Ryandev/n64-classic-mini-cad/(commit log)

2026-11-11 feat(cad): 50% N64-style case for the Radxa X4
    A parametric CadQuery enclosure with a geometry gate (135 rows) and a
    mutation self-test. CI builds every printed part and the print plate from a
    fresh clone; the reference-model checks run locally (see CREDITS.md).
    Published as one commit: earlier history held third-party marks.
2026-11-11 docs(cad): front, rear and print-plate pictures with the CLASSIC plaque
    Rendered in FreeCAD from the current export (the public CLASSIC lettering).
2026-11-11 chore(cad): ignore local even as a symlink
    The private workspace links cad/local in from outside the repo; a trailing
    slash only matches real folders.
2026-11-11 fix(cad): environment.yml builds from scratch
    ocp_vscode and ruff are PyPI packages, not conda ones, so micromamba could not
    solve the file and every CI run failed at environment setup. The local
    environment had them from pip, so nobody had built the file fresh. Both move to
    the pip section at the versions in use. Verified by creating a new environment
    from the file and running the CI steps against a clean clone.
2026-11-11 feat(cad): active cooling with a measured thermal budget (REQ-04)
    The case was effectively sealed (top louvers a 0.28 mm cosmetic cut) and
    the design milled a heat sink nobody can mill. Replaced with bought parts
    that fit as supplied:
    - Same Sky HSB26-343408 pin-fin heat sink on the N100 with paste (the stock
    silicone pad is the X4 cooler's known bottleneck), clamped by the printed
    duct's cover, which the cartridge cradle presses through a 0.5 mm pad.
    - Sunon MF30060V2 30x30x6 fan (15.7 dB(A)) under the 25 louvers, now cut
    through, blowing room air down a sealed duct through the pins. A 10 mm
    fan can't fit: it must clear the USB retainer bridge and the roof.
    - Exhaust: 9 floor vents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
2026-11-12 fix(cad): close the fan's bypass past the cooling duct (COOL_FAN)
    The fan reached 4.6 mm in front of the duct's front wall, and between the USB retainer
    brackets that strip was open down to the tub floor: 13 % of the blade area (66 mm2) blew
    into the case instead of through the heat sink, and lowered the plenum pressure. The owner
    spotted it in FreeCAD. COOL_SEAL had missed it because it treats the fan as a solid wall,
    and the thermal model sends the whole flow through the pins.
    - The duct gains a pocket under that strip (floor above the LED, side walls 0.2 mm inside
    the brackets, front wall under the fan frame), and its old front wall opens into it, so the
    strip blows into the plenum i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
2026-11-12 fix(cad): grade the case against Radxa's own board (C10); doors open to 90 deg (C1)
    C10: the Radxa X4 reference had been assembled by hand (connectors picked
    by index, an invented HDMI shield, a USB-C socket cut "to clear the
    standoff"), so every clearance row graded the case against a board edited
    to pass. `./run radxa-ref` (lib/step/build_radxa_x4.py) now builds it from
    Radxa's download: SHA-256 pinned, all 363 solids, moved only so its four
    mounting holes sit on the datum. New row RADXA_REF; CI builds it too.
    On the real board the duct, the upper shell and a standoff touched parts
    the edited model lacked: duct and shell reliefs, and the Radxa standoffs
    step to a 6.4 mm contact face for th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
2026-11-12 chore(cad): drop the hand-built Radxa STEP; notes on running heavy checks
    lib/component/radxa_x4_deported.step was the hand-built board input (C10),
    no longer read by anything; the assembly now labels Radxa's real model
    radxa_x4. Deleted with the owner's approval. AGENTS.md: N64_GATE_JOBS,
    selftest --only, one heavy job at a time.
2026-11-12 fix(cad): Omron switches screwed from behind the tower (C2)
    The hole-2 M2 screw entered from the switch's front, where its head and
    washer sat 25.5 mm3 inside the USB-A socket and no driver could reach it.
    Owner's design: a 3 x 10 thread-forming screw for plastics, driven from
    behind the tower (before the Radxa board) through a 3.4 mm clearance
    hole, rolls its own thread in the switch's 2.35 mm hole and clamps the
    switch to the tower: no play, nothing on the switch's front. The M2
    inserts, screws and washers go. Bench-test on a spare switch first.
    New row OMRON_SCREW (clear of tub/switch/USB/bracket, >= 4 mm engaged,
    tip >= 0.3 mm inside the switch front, 40 mm driver path); the screws
    are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
2026-11-12 fix(cad): every Omron switch clicks; buttons press the lever at their centre (C3)
    The buttons' flat underside met the switch lever's raised tip (1:1, 4 mm
    off-centre), and with 1.9 mm of travel a nominal SS-5GL (OP 8.8) never
    clicked; OMRON_ACT passed because it multiplied constants (a 0.72 ratio
    nothing produced). Owner chose a press point under the button centre:
    the underside is 0.33 mm lower with pockets either side of a 1.2 mm ridge
    72% along the lever, and travel is 2.10 mm (stops follow BUTTON_STOP_Z).
    OMRON_ACT now moves each real button down the real lever (Omron SS
    datasheet values): tip 10.66 mm at rest (releases every switch, margin
    0.26) and 7.82 at the stop (clicks every switc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
2026-11-12 fix(cad): REAR_IO measures the real RJ45 jack, not a relaxed width (C5)
    REAR_RJ45_BAY_W was a hand-set 24.0 relaxed to 20.5 so the row passed,
    its label still claiming 24. The row now requires the real jack assembly
    (17.0 mm) to sit >= 1.0 mm from the board and >= 0.5 mm from the wall
    (measured 1.0 / 3.0 in a 21.0 mm bay); the constant is gone. Red-
    confirmed: moving the jack onto the board fails REAR_IO.
2026-11-13 fix(cad): rows measure the solids; corner screws M3x14 (C8, C9)
    C8: SCALE, SCAN_50 and J01_SPLIT compare against the real N64 shell
    model at 50 % (was: datum constants vs hand-copied scan numbers);
    HANDED measures the built parts (POWER left, ports front, I/O rear,
    deck up; was the determinant of a constant matrix); RADXA_FIT and
    REAR_IO probe the tub's real walls (new lib/testing/probe.py); J01's
    lip gap and J07's light-pipe gap are measured (0.155 and 0.060 mm).
    Selftest mutations added for RADXA_FIT, M2_CLEAR, G13_FULL, G13_TOP,
    J04_RESET, J06_BEZEL, J07_PIPE, G13_FRONT and a mirrored-ports HANDED;
    all caught.
    C9: the M3x12 corner screws reached only 2.8 mm into their RX-M3x5.7
    inserts;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
2026-11-13 fix(cad): FEM with C3D10, converged meshes and real supports (C4)
    The FEM's peak stresses sat on point loads and clamps and didn't
    converge, its C3D4 tetrahedra were far too stiff, it clamped whole
    edges, it couldn't find its tools (gmsh/ccx missing from
    environment.yml, a lowercase glob for FreeCAD's AppImage), and LC2
    had silently lost its button-press load when the stop moved (C3).
    Now: straight-sided C3D10 (curved ones inverted on the tub); each case
    solved on two meshes (0.7x) that must agree within 15 %; stress judged
    at the 99th percentile clear of loads and supports; the tub rests on
    its floor, held sideways under the feet, the shell on the tub's rim,
    screwed at its corners; LC4's l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
2026-11-13 fix(cad): one XY datum per button; placed exports and the torus check tested (C9, D4)
    C9 (rule 3): each button was located in XY by both its shell chimney
    (0.22 mm a side) and the bracket's guide pole (0.20), on different
    parts whose placement stack (lip 0.15 + glued bracket 0.20) exceeds
    either clearance, so a button could bind. The chimney is the datum; the
    pole hole grows to Ø4.0 (0.57 mm a side, the whole stack) with a flat
    roof 0.3 mm above the pole tip at full stroke. New row BTN_DATUM
    measures both gaps on the solids; red-confirmed with the old Ø3.2.
    D4: export_validate compared placed component exports with get_shape();
    export_harness.export_shape() is now the one definition both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
2026-11-13 feat(cad): heat sink corner stops, V-bottom switch pin, print-test coupons
    The heat sink could slide 5.7 mm forward and more than 6 mm back on the die, held only by clamp
    friction and paste. Front posts hang from the duct cover and rear hooks from the skirts, 0.3 mm
    clear; row HS_STOP moves the sink 0.5 mm each way and needs it to meet the duct (red-confirmed:
    HS_STOP_GAP 0.3 -> 2.0 is caught). COOL_SEAL still seals.
    The Omron locator pin was a round 6.4 mm horizontal cantilever whose underside couldn't print;
    it now has a 45 deg V underside inscribed in the Ø2.2 circle. BTN_DATUM crops the poles once.
    ./run coupons cuts five print-test coupons from the real parts (button/chimney, switch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
2026-11-13 feat(cad): flat tub bottom, overhang row that fails, printing notes, hole gauge
    The tub's stepped underside (raised feet and label pad, floor 0.45-0.9 mm up) left ~9,500 mm^2
    of floor printing in mid-air. The underside is hidden under the Bumpon feet and the owner only
    replicates what is visible (C9, 2026-11-13), so the bottom is now flat at z 0 (bed contact
    2,176 -> 11,267 mm^2). The floor vents cut the thicker floor: declared 372.6 -> 518.4 mm^3.
    The overhang row was advisory and always passed, which is how the floating floor got through.
    It now fails any downward face wider than a 10 mm bridge (width = short side of the face's
    equivalent rectangle), unless the part declares SUPPORT_MM2 w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
2026-11-13 refactor(cad): delete five unused LED datums
    LED_SHAFT_D, LED_BORE_D and LED_BICOLOUR_D/_BORE_D/_RIM_D were read by nothing; the last three
    described a 10 mm LED that isn't fitted (the console uses a 3 mm L-93WEGW). Owner approved the
    deletion 2026-11-13 (C8). Gate green, 157 rows.
2026-11-13 feat(cad): glue-in duct floor plate; FEM flex limits set by function
    Duct (owner, 2026-11-13): printed upside down, the plenum floor was a 34 x 16 mm roof over the
    fan bore that needed support inside the duct. It is now a separate plate (part/duct_floor.py,
    printed flat) glued into a frame with a 1 mm ledge and 0.15 mm a side clearance (GBA's measured
    PETG locating fit); the epoxy bead seals the plenum. The duct prints support-free. New row
    FLOOR_SEAT; G13_COOL now checks the plate fits its frame. Mutations: plate too big (G13_COOL),
    ledge out of reach (FLOOR_SEAT); both caught. COOL_SEAL still seals.
    FEM (C4, owner chose "don't reinforce"): each flex limit now comes from what the part must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
2026-11-13 docs(cad): PETG Basic for every printed part; printing for paint; orientation study
    Owner, 2026-11-13: one material, PETG Basic, for every printed part (no PETG-CF, no ASA, no
    resin). PRINTING.md records why each alternative was dropped and adds "printing for paint"
    (orientation, variable layers, ironing, 2K filler primer, and paint closing sliding fits). The
    duct runs close to PETG's limit, so the on-console thermal test should also check it. BOM
    regenerated.
    ./run orient (lib/orientation_study.py) sorts each visible part's outer skin into wall / top /
    bed / terraced / underside / support for each of the six bed orientations, so the owner can pick
    the fewest layer lines on painted faces.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
2026-11-13 fix(cad): orientation study judges visibility on the assembled case
    A face counts as visible only if a ray from it escapes the closed console (printed parts),
    so a button's stem in its chimney or a wall inside the tub no longer counts; normals come
    from each face's own (u, v) centre (the projection of its 3D centre failed on some faces).
2026-11-13 feat(cad): paint allowance on every painted fit; true-offset jewel and LED pockets
    Owner, 2026-11-13: everything visible is painted, with no masking. Paint closes a visible gap,
    so each painted fit is now drawn at its working clearance plus the paint it gains: PAINT_T =
    0.15 mm per face (basecoat + clear on unsanded gap edges, GBA's film figures; provisional until
    a painted coupon is measured). Door in bay and cartridge flaps: both faces painted (+0.30); the
    clear jewel and LED lens: one face (+0.15). The door's sill drops by the allowance instead of the
    door and pivot rising, so its swing and hinge pins are unchanged. The buttons aren't opened: their
    sliding faces are hidden in the chimneys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
2026-11-13 docs(cad): FEM results against the functional flex limits
    With the flat tub bottom the floor is supported, and the button stop and standoff flex dropped
    from ~0.3 mm to 0.05 and 0.01 mm: every case is inside its stress and flex limits. LC1 (31 %)
    and LC4 (23 %, on a 0.06 MPa stress) still miss the 15 % mesh-convergence test, so the FEM stays
    out of the gate for now (C4).
2026-11-14 docs(cad): re-render front, rear and print-plate pictures; N64_PUBLIC forces CLASSIC
    The README pictures predated the flat tub bottom, the split duct and the paint allowance. The
    first re-render from a local export carried the owner's private plaque lettering (cad/local/),
    caught on review before committing. N64_PUBLIC=1 now forces the public CLASSIC lettering for
    anything rendered for the published repo; CI never has cad/local/, so releases were already
    clean. Lesson recorded in AGENTS.md.
    Gate green, 164 rows.
2026-11-14 fix(cad): findings from the Gemini adversarial review (2026-11-14)
    Each finding was checked against the code first (verdicts in the private review notes).
    - #1 Two planted defects (J09_FLAPS, J05_COVER) searched for text the paint change had renamed,
    so the full self-test would have failed on them. Fixed, and `./run lint` now checks that every
    mutation's text exists (red-confirmed with a planted stale snippet). J09_FLAPS measured the
    datum against a band; it now measures the flap gap on the solids.
    - #4 FLOOR_SEAT took the whole-solid distance (wall contact passed as "seated") and printed the
    frame gap as a constant. It now measures the seat (plate top skin against the duct above) a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
2026-11-14 fix(cad): FEM reports where the percentile stress sits; README table with the stop-shelf flex
    LC1's bracket stop shelf gives 0.18 mm under the 50 N mash, past the switch's 0.158 mm over-travel
    margin (graded since the Gemini review, #5). LC1's p99 stress sits at the middle leg's root under
    the bridge, a sharp inside corner, which is why it never converges with mesh size. Both are open
    decisions in RELEASE_TODO E.
2026-11-14 feat(cad): coupon 1 also prints the power button on its side, to compare finishes
    The orientation study's 100 %-wall pick stands the button on its round end with no flat bed
    contact; on its straight side it is 74 % wall and 26 % underside (needs a brim). Printed next to
    the top-up button so the owner can choose.
